alexanderenrique/attiny-e-ink/PCB/attiny-e-ink/attiny-e-ink.csv

Reference | Qty | Value
C1,C2 | 2 | 0.1uF
C3,C4 | 2 | 1uF
C5,C6,C7 | 3 | 4.7uF
D1 | 1 | LED
J1 | 1 | e-ink-display
J2 | 1 | Micro_SD_Card_Det_Hirose_DM3AT
J3 | 1 | Battery
J4 | 1 | USB4085-GF-A
Q1,Q2,Q3 | 3 | DMG2301L
R1,R2,R5 | 3 | 1M
R3,R4 | 2 | 100k
R6 | 1 | 420
R7 | 1 | 10k
R8,R9 | 2 | 5.1k
S1 | 1 | TL1105MF160Q
TP1 | 1 | GND
TP2 | 1 | UPDI
TP3 | 1 | 3.3V
U1 | 1 | ATtiny3226-S
U2 | 1 | TPS7A0233PDBVR
U3 | 1 | MCP73832
