alexanderenrique/attiny-e-ink/fact-aggregator/categorized/history.txt

#History Facts
Telly Savalas and Louis Armstrong died on their birthdays.
Ramses brand condom is named after the great pharaoh Ramses II who fathered over 160 children.
The youngest pope ever was 11 years old.
Australian soldiers used the song "We're Off to See the Wizard" as a marching song in WWII.
When the Titanic sank, 2228 people were on it. Only 706 survived.
A B-25 bomber crashed into the 79th floor of the Empire State Building on July 28, 1945.
King Louis XIX ruled France for 15 minutes.
Jefferson invented the dumbwaiter, the monetary system, and the folding attic ladder.
Baby Ruth candy bar was named after Grover Cleveland’s daughter, Ruth, not the baseball player.
Daniel Boone hated coonskin caps.
In the great fire of London in 1666 half of London was burnt down but only 6 people were injured.
Ancient Egyptian priests would pluck every hair from their bodies.
The electric chair was invented by a dentist.
Adolf Hitler was a vegetarian, and had only ONE testicle.
The first streetlights in America were installed in Philadelphia around 1757.
Johnny Appleseed planted apples so that people could use apple cider to make alcohol.
Samuel Clemens (Mark Twain) was born on and died on days when Halley’s Comet can be seen.
Alabama was the first state to recognize Christmas as an official holiday.
Leonardo da Vinci could write with one hand while drawing with the other
The NY phone book had 22 Hitlers before WWII. The NY phone book had 0 Hitlers after WWII.
The skeleton of Jeremy Bentham is present at all important meetings of the University of London
The Black Death reduced the population of Europe by one third in the period from 1347 to 1351.
Stephen Hawking was born exactly 300 years after Galileo died.
While in Alcatraz, Al Capone was inmate #85.
The very first bomb dropped by the Allies on Berlin during World War II Killed the only elephant in the Berlin Zoo.
John Wilkes Booth’s brother once saved the life of Abraham Lincoln’s son.
US gold coins used to say “In Gold We Trust”.
The first contraceptive was crocodile dung used by the ancient Egyptians.
Sir Isaac Newton was only 23 years old when he discovered the law of universal gravitation.
Winston Churchill was born in a ladies` room during a dance.
Winston Churchill was born in a ladies room during a dance.
Lee Harvey Oswald's cadaver tag sold at an auction for $6,600 in 1992.
Arizona was the last of the 48 adjoining continental states to enter the Union.
The first McDonald's restaurant in Canada was in Richmond, British Columbia.
The word Pennsylvania is misspelled on the Liberty Bell.
The first bomb the Allies dropped on Berlin in WWII killed the only elephant in the Berlin Zoo.
In 1778, fashionable women of Paris never went out in blustery weather without a lightning rod attached to their hats.
Ancient Egyptians shaved off their eyebrows to mourn the deaths of their cats.
Hannibal had only one eye after getting a disease while attacking Rome.
In the last 3,500 years, there have been approximately 230 years of peace throughout the civilized world.
In 1386, a pig in France was executed by public hanging for the murder of a child
Paper was invented early in the second century by Chinese eunuch.
Al Capone`s business card said he was a used furniture dealer.
Mike Nesmith`s (the guitarist of The Monkeys) mom invented White Out.
In the Philippine jungle, the yo-yo was first used as a weapon.
An American urologist bought Napoleon’s penis for $40,000.
Benjamin Franklin was the fifth in a series of the youngest son of the youngest son.
The S in Harry S. Truman did not stand for anything.
Thomas Edison, acclaimed inventor of the light bulb, was afraid of the dark.
Leonardo Da Vinci invented the scissors, the helicopter, and many other present day items.
The Declaration of Independence was written on hemp (marijuana) paper.
Every US president has worn glasses (just not always in public).
Napoleon`s penis was sold to an American Urologist for $40,000.
All US Presidents have worn glasses; some just didn`t like being seen wearing them in public.
Albert Einstein and Charles Darwin both married their first cousins
Einstein couldn`t speak fluently until after his ninth birthday. His parents thought he was mentally retarded.
Frank Lloyd Wright's son invented Lincoln Logs.
The U.S. bought Alaska for 2 cents an acre from Russia.
Dr. Kellogg introduced Kellogg`s Corn Flakes in hopes that it would reduce masturbation.
The shortest British monarch was Charles I, who was 4 feet 9 inches.
Anne Boleyn, Queen Elizabeth I's mother, had six fingers on one hand.
Arabic numerals are not really Arabic; they were created in India.
The shortest war in history was between Zanzibar and England in 1896. Zanzibar surrendered after 38 minutes.
The world’s oldest piece of chewing gum is 9000 years old!
Yo-yos were used as weapons by warriors in the Philippines in the 16th century.
Michigan was the first state to have roadside picnic tables.
John Adams, Thomas Jefferson, and James Monroe died on July 4th.
Most Egyptians died by the time they were 30 about 300 years ago,
Wyoming was the first state to give women the right to vote in 1869.
In medieval France, unfaithful wives were made to chase a chicken through town naked.
Julius Caesar’s autograph is worth about $2,000,000.
The Ramses brand condom is named after the great pharoh Ramses II who fathered over 160 children.
Eating the heart of a male Partridge was the cure for impotence in ancient Babylon.
Pamela Anderson Lee is Canada`s Centennial Baby, being the first baby born on the centennial anniversary of Canada`s independence.
Al Capone’s business card said he was a used furniture dealer.
Jimmy Carter was the first U.S. President to be born in a hospital.
In ancient Rome, when a man testified in court he would swear on his testicles.
Adolf Hitler's mother seriously considered having an abortion but was talked out of it by her doctor.
President John F Kennedy could read 4 newspapers in 20 minutes.
Leonardo Da Vinci invented the scissors.
The earliest known use of cryptography dates to 1900 BC
Frequency analysis, the technique for breaking substitution ciphers, was invented by Arab mathematician Al-Kindi around 800 AD
The Great Cipher used by King Louis XIV remained unbroken for over 200 years (1690-1890)
Polish mathematician Marian Rejewski broke the German Enigma cipher in 1932 using only mathematics and limited documentation
Breaking Enigma shortened World War II by an estimated two years
Public-key cryptography was secretly developed at GCHQ by James Ellis, Clifford Cocks, and Malcolm Williamson in 1973-74
The Zimmermann Telegram's decryption triggered the United States' entry into World War I
Frank Rosenblatt and Marvin Minsky were schoolmates at Bronx High School of Science
Kurt Gödel wrote to John von Neumann in 1956 asking whether theorem-proving could be solved in quadratic time
John Nash wrote to the NSA in 1955 speculating that cracking a sufficiently complex code would require exponential time
The Turing machine was invented in 1936 by Alan Turing
The term 'Turing machine' was coined by Alonzo Church, Turing's doctoral advisor, in a paper review
The FBI seized about 30,000 BTC from Silk Road in October 2013 after arresting founder Ross Ulbricht
Geoffrey Hinton, Yann LeCun, and Yoshua Bengio won the 2018 Turing Award for their work on deep learning
Alan Turing cracked the Enigma code at Bletchley Park
Turing was prosecuted for homosexuality in 1952 and chemically castrated
The South Sea Bubble of 1720 saw shares in the South Sea Company rise 800% in months before collapsing
The 1907 Bankers' Panic was halted by J.P. Morgan personally convincing bankers to contribute to a pool of funds
The Mississippi Bubble of 1720 in France saw John Law's company shares rise 20-fold before collapsing
The German hyperinflation of 1923 was deliberately created to make reparations payments worthless
The Panic of 1893 was triggered by over-expansion of railroads and bank failures
The British Railway Mania of 1847 saw one-third of authorized railways never built after the bubble burst
The Knickerbocker Trust collapse in 1907 triggered a run on other trusts
The Penn Central Railroad bankruptcy in 1970 was the largest in US history at the time
The Lehman Brothers collapse on September 15, 2008 triggered the worst phase of the financial crisis
The Northern Rock bank run in 2007 was the first run on a British bank in 150 years
Experimental economics earned Vernon Smith the 2002 Nobel Prize
The oldest evidence of winemaking dates to around 6000 BC in Georgia, in the Caucasus region.
Nutmeg, native to the Banda Islands in Indonesia, was introduced to Europe by the 6th century BCE.
Cave paintings in Spain show humans gathering honey at least 8,000 years ago.
Mayans practiced large-scale meliponiculture (stingless bee keeping) since pre-Columbian times.
Cacao was considered a gift from the gods by both the Maya and the Aztecs, and cocoa beans were used as currency.
It took until 1585 for the first official shipment of cocoa beans to reach Europe from the Americas.
All 13 vitamins were discovered between 1910 and 1948, revolutionizing our understanding of nutrition.
The ancient Egyptians knew that feeding liver (rich in vitamin A) could cure night blindness, though they didn't know why.
Wild olives were collected by Neolithic people as early as the 8th millennium BCE in Asia Minor.
The first probiotic discovered was Lactobacillus bulgaricus in Bulgarian yogurt, identified by Stamen Grigorov in 1905.
The term 'antioxidant' originally referred to chemicals that prevented oxygen consumption in industrial processes like rubber vulcanization.
Cheese making dates back at least 7,500 years—ancient pottery with milk fat residue has been found from that era.
Cheese was likely discovered accidentally when milk stored in animal stomach pouches curdled from residual rennet enzymes.
Beer brewing dates back at least 5,000 years to ancient Sumer, where it was considered a divine gift.
Black pepper was once so valuable it was called 'black gold' and used as currency in medieval trade.
Sushi originally meant fermented fish preserved in rice for months—modern 'fast sushi' developed in 19th-century Tokyo.
Tofu was invented in China around 2,000 years ago, possibly by accident when nigari (a coagulant) contaminated soy milk.
Ketchup was originally made from fermented fish or mushrooms in 18th-century Britain—tomato ketchup is an American invention from the 1800s.
Mustard is one of the world's oldest condiments—it has been used for over 5,000 years, originally in ancient China and India.
Francis Galton calculated in 1892 that the chance of two different individuals having the same fingerprints was about 1 in 64 billion.
The Vinland Map was identified as a 20th-century forgery through chemical trace evidence analysis of its ink composition.
Archibald Reiss founded the world's first school of forensic science at the University of Lausanne in 1909.
The FBI launched its Computer Analysis and Response Team in 1984, marking the beginning of specialized digital crime investigation units.
SMS data from mobile forensics helped exonerate Patrick Lumumba in the Amanda Knox case (murder of Meredith Kercher).
The Thomas Onofri kidnapping was solved in 2006 through mobile phone location data tracked via cell site logs.
The Jack the Ripper case from 1888 remains unsolved over 135 years later, despite numerous theories and modern forensic analysis attempts.
The Wall Street bombing of 1920 has never been positively solved, though the Galleanist anarchist group is widely believed responsible.
The Dos Erres massacre conviction resulted in sentences of 6,060 years for each perpetrator—among the longest prison sentences ever issued.
The first known manual alphabet for deaf people was developed by a Spanish monk, Pedro Ponce de León, in the 16th century.
The oldest known dictionary is from ancient Mesopotamia (c. 2300 BCE) — a Sumerian-Akkadian bilingual word list.
The Rosetta Stone (196 BCE) contained the same text in three scripts: hieroglyphic, demotic Egyptian, and Greek
Quipu, the Incan system of knotted cords, could encode administrative data but remains only partially deciphered
Cuban insurgents during Spanish occupation developed a secret whistled language for communication
The first practical piezoelectric application was sonar during World War I, developed by Paul Langevin in 1917 for detecting submarines.
The Lyres of Ur, excavated from Sumerian graves dated 2600-2500 BC, represent one of the first ensembles of instruments ever discovered.
In 1902 alone, there were 70,000-75,000 player pianos manufactured and 1-1.5 million piano rolls produced in the United States.
The Dyatlov Pass incident, where nine Soviet hikers died mysteriously in 1959, has infrasound hypothesized as one possible cause of death.
In ancient China, written records describe music as essential medicine—'at the end of a song, people were safe when they were discharged'.
The first bagpipes appeared in the 9th century and spread throughout Europe, serving functions from folk instruments to military use.
Underwater acoustics was first used militarily to detect submarines in World War I.
Lord Rayleigh's The Theory of Sound (1877) combined all previous acoustic knowledge and remains influential in the field today.
Thomas Edison may have accidentally created graphene in 1879 while testing carbon-based bamboo filaments for light bulbs
The tin can was patented in 1810 by Peter Durand, but the can opener wasn't patented until 1858
Marie Curie remains the only person to earn Nobel Prizes in two different sciences (Physics in 1903 and Chemistry in 1911).
In 1912, Barnum & Bailey trained elephants to play baseball - they used the image on posters to sell circus tickets.
Dream interpretation was practiced by Babylonians as early as the third millennium BCE.
Calvin S. Hall collected over 50,000 dream reports between the 1940s and 1985 for scientific analysis.
In ancient Sumer, King Gudea rebuilt a temple based on instructions received in a dream around 2140 BCE.
Scientists who discovered REM sleep in 1953 were Eugene Aserinsky and Nathaniel Kleitman.
Thomas Edison slept only 4 hours a night and promoted the idea that sleep was a waste of time.
Leonardo da Vinci allegedly practiced polyphasic sleep with multiple 20-minute naps throughout the day.
Copper has been used by humans for over 10,000 years and remains essential in electrical wiring due to its conductivity.
Lead has been used for 6,000 years and was once added to gasoline, paint, and even food as a sweetener.
Tin has been alloyed with copper to make bronze since 3000 BCE, revolutionizing human civilization.
Aluminum was once more valuable than gold - Napoleon III served honored guests with aluminum cutlery while others used gold.
Hammurabi was discovered by Austen Henry Layard.
An official investigation found the Fukushima nuclear accident was foreseeable and preventable.
Approximately 85 per cent of Welsh children were not in school in 1821.
The Palace Theater light bulb has been running since 1908.
Trembleuse cups and saucers enabled people with unsteady hands to drink hot beverages.
French soldiers interred in Bayonet Trench were popularly believed to have been buried alive with their rifles in their hands.
Bob Hobman recreated a possible sea journey by Palaeolithic humans after 130,000-year-old tools were found on the island of Crete.
An enigmatic ancient site deep in Madagascar (Teniky) may have been built by Zoroastrians.
Kent Brushes have supplied their products to every British monarch since George IV.
The Haitian Revolution began when Cécile Fatiman sacrificed a black pig, a ritual later repeated by Haitians resisting foreign occupation.
An ancient Canadian archaeological site (GhGk-63) was discovered during the construction of a dump.
A Cretan man found a 1st-century statue of Aphrodite (Aphrodite Rhithymnia) while trying to drill a well, and then reburied it.
The Italian Campaign of 1796–1797 demonstrated that Napoleon was a 'great strategist'.
Papyrus Bingen 45 may contain a word handwritten by Cleopatra.
Cecil Kent Drinker published his report on the Radium Girls only after a forged version was submitted in his name.
The Indian emperor Jahangir commissioned a painting depicting his superiority over his rival, the Shah of Iran.
German colonists were unable to win a war that they started with an unprovoked massacre (Hornkranz massacre).
The concept of genocide was introduced in the 1944 book Axis Rule in Occupied Europe.
A shipwreck in the eastern Mediterranean, dating from the Late Bronze Age, is the earliest deep-sea shipwreck to be discovered.
John S. McCain Sr. and John S. McCain Jr. were the first father-and-son pair to achieve the U.S. rank of four-star admiral.
Lionel Haward applied an early example of offender profiling to help identify high-ranking Nazis disguised as ordinary troops.
Niall Ó Glacáin, an Irish physician, worked as a travelling plague doctor in southern France in the 1620s.
The surviving copies of the Kitab-ı Bahriye contain a total of more than 5,700 maps.
The September 11 Digital Archive argues that even its misinformation is useful to the historical record.
The Zoninus collar is the only known Roman slave collar that offers a reward for returning its wearer.
A nuclear reactor was nearly built at the New York Hall of Science, but the money instead went to Yankee Stadium.
38 per cent of Welsh university students in 1900 were women.
The British Army's Submarine Mining Service defended ports and harbours with naval mines and torpedoes.
30 royal portraits of Korean kings were completely destroyed in a 1954 fire in Busan, South Korea.
Darwin's first sketch of an evolutionary tree" src="//upload.
The first prize in physics was awarded in 1901 to Wilhelm Conrad Röntgen, of Germany, who received 150,782 SEK.
John Bardeen is the only laureate to win the prize twice—in 1956 and 1972.
William Lawrence Bragg was the youngest Nobel laureate in physics; he won the prize in 1915 at the age of 25.
A 2020 study reported that half of the Nobel Prizes for science awarded between 1995 and 2017 are clustered in few disciplines.
The first Nobel Prize in Chemistry was awarded in 1901 to Jacobus Henricus van 't Hoff, of the Netherlands.
The first Nobel Prize in Physiology or Medicine was awarded in 1901 to Emil Adolf von Behring, of Germany.
In 1939 Gerhard Domagk, a German, was not allowed by his government to accept the prize.
First African-American woman to receive a United States patent.
Levin was not aware of Cook's achievement because of communication difficulties between East and West during the Cold War.
The Moon Halley wasn't the first to figure out the famous comet.
An 11th-century monk did it first, new research suggests.
Cleopatra lived closer in time to the Moon landing than to the building of the Great Pyramid.
Oxford University is older than the Aztec Empire.
The inventor of the frisbee was turned into a frisbee after death — his ashes were molded into memorial discs.
The shortest war in history lasted 38 minutes — between Britain and Zanzibar in 1896.
The inventor of the Pringles can is buried in one, as per his request.
A 'moment' was a medieval unit of time equal to 90 seconds.
The inventor of the steamboat was an artist first.
The inventor of the telegraph was also a painter.
The inventor of silk discovered it accidentally.
Nikola Tesla had a photographic memory and could visualize entire machines in his head, building them mentally before ever touching a tool.
Darwin waited 20 years to publish On the Origin of Species because he knew how controversial it would be.
Isaac Newton invented calculus during quarantine when Cambridge closed due to the plague.
Einstein's brain was stolen during his autopsy and kept in jars for decades before being studied.
The scientist who proposed hand-washing to prevent infection was ridiculed by the medical community and died in an insane asylum.
Galileo's middle finger is on display in a museum in Florence, Italy.
Leonardo da Vinci wrote backwards in mirror script, possibly to keep his ideas secret or because he was left-handed.
Werner Heisenberg, creator of the uncertainty principle, got a C in lab work because his experimental skills were poor.
Aristotle believed women had fewer teeth than men — he never bothered to count, despite having two wives.
Benjamin Franklin nearly electrocuted himself and was knocked unconscious while experimenting with electricity.
Carl Sagan applied to work at NASA but was rejected
Einstein was offered the presidency of Israel but declined, saying he lacked the natural aptitude for dealing with people.
Thomas Edison electrocuted an elephant named Topsy to prove the dangers of his rival Tesla's AC current.
Archimedes was killed by a Roman soldier while doing geometry in the sand
Darwin and Lincoln were born on the exact same day — February 12, 1809.
Louis Pasteur was so afraid of germs that he refused to shake hands with people.
Copernicus's book proposing heliocentrism was only banned by the Catholic Church 73 years after publication.
Pythagoras's followers kept his teachings secret and were sworn to silence
Robert Hooke and Isaac Newton were bitter rivals — Newton allegedly had Hooke's portrait destroyed after Hooke died.
Marie Curie remains the only person to win Nobel Prizes in two different sciences: Physics and Chemistry.
The ancient Egyptians used moldy bread to treat infected wounds — accidentally discovering antibiotic properties.
Lavoisier, the father of modern chemistry, was executed during the French Revolution
Feynman cracked safes at Los Alamos for fun during the Manhattan Project, causing security concerns.
Wernher von Braun designed rockets for Nazi Germany before becoming the architect of NASA's Apollo program.
Ancient Babylonians were doing trigonometry 1,000 years before the Greeks — clay tablets prove it.
Lobsters were once considered food for the poor.
The inventor of the telephone, Alexander Graham Bell, never called his wife or mother.
The inventor of Pringles is buried in a Pringles can.
The shortest war in history lasted 38 to 45 minutes.
The inventor of the frisbee was cremated and made into frisbees.
Cleopatra lived closer to the Moon landing than to the building of the Great Pyramid.
Nintendo was founded in 1889 as a playing card company, over 100 years before they made video games.
The first alarm clock could only ring at 4 AM because it was made for factory workers.
The match was invented 27 years after the lighter — lighters came first in 1823, matches in 1850.
The ancient Egyptians used mashed brains as a contraceptive.
Romans used crushed mouse brains as toothpaste.
Cleopatra spoke nine languages and was the first Ptolemaic ruler to learn Egyptian.
The Library of Alexandria may have contained 400,000 to 700,000 scrolls.
Vikings used the bones of slain animals as skates.
Mummies have been found with cocaine and tobacco traces, suggesting pre-Columbian trade routes.
Doctors used to taste urine to diagnose diabetes — sweet urine indicated the disease.
Walt Disney was originally offered a deal that was worth $2 billion to create a theme park in Missouri.
Play-Doh was originally a wallpaper cleaner.
Nintendo was founded in 1889 as a playing card company.
Zero was invented independently in India and by the Maya, but the Romans never had a symbol for it.
Roman numerals have no symbol for zero, which made complex math nearly impossible.
A baker's dozen (13) exists because medieval bakers could be punished for short-changing customers.
The number 666 is called the 'number of the beast,' but some ancient manuscripts say it's actually 616.
The ancient Egyptians only used unit fractions (1/n) and had to express 2/5 as 1/3 + 1/15.
The ancient Babylonians used base-60, which is why we have 60 seconds in a minute and 360 degrees in a circle.
The inventor of vaseline ate a spoonful every day.
The Titanic was carrying 12 dogs, 3 of which survived.
Ancient Romans used urine to whiten their teeth.
The inventor of the Frisbee was cremated and turned into frisbees.
Cleopatra lived closer to the iPhone than to the pyramids.
The shortest war lasted 38 minutes.
The inventor of the lobotomy won a Nobel Prize.
The inventor of the fire hydrant is unknown — records burned.
The inventor of the Pringles can is buried in one.
Phosphorus was discovered by a German alchemist boiling his own urine to find gold
The inventor of the treadmill created it as a prison punishment.
The inventor of the AK-47 regretted his creation.
The inventor of dynamite created the Nobel Prize.
The inventor of the telephone never called his family.
The inventor of the guillotine opposed the death penalty.
The inventor of the escalator was afraid to ride it.
The inventor of the shopping cart hired actors to use it.
The inventor of barbed wire changed the American West.
The inventor of the sewing machine had his shop burned down.
The inventor of the cotton gin made slavery more profitable.
The inventor of the bra was a socialite.
The inventor of the printing press was a goldsmith.
The inventor of the parachute never tested it himself.
The inventor of the revolver was 18 years old.
The inventor of the phonograph was partially deaf.
German chocolate cake was named after Sam German, not Germany.
Cotton candy was co-invented by a dentist in 1897.
Mountain Dew was originally created as a whiskey chaser.
The shortest war in history lasted 38-45 minutes between Britain and Zanzibar on August 27, 1896.
Cleopatra lived closer in time to the Moon landing than to the construction of the Great Pyramid.
The inventor of the Pringles can is buried in one - Fredric Baur's ashes were placed in a Pringles can.
The inventor of the fire hydrant is unknown because the patent was destroyed in a fire.
The first alarm clock could only ring at 4 AM - invented by Levi Hutchins in 1787.
The inventor of Vaseline ate a spoonful of it every day believing it had health benefits.
The shortest war in history was between Britain and Zanzibar in 1896 - Zanzibar surrendered after just 38 minutes.
The inventor of the telephone, Alexander Graham Bell, never called his wife or mother because they were both deaf.
The shortest war ever fought lasted only 38 minutes.
The first photograph ever taken was in 1826 and required an 8-hour exposure.
The oldest known cave painting is over 64,000 years old, found in Spain.
One estimate is that 85 per cent of children in Wales aged five to fifteen were not in day school in 1821.
In a murder case dated 1235, a Chinese magistrate had villagers assemble and set down their sickles
From 1892 to 1924, Ellis Island was America's largest and most active immigration station, where over 12 million immigrants were processed.
Ferdinand Magellan named the Pacific Ocean after entering it in November 1520, because of the calmness of the water at the time.
On his midnight ride, Paul Revere was intercepted by a British patrol after leaving Lexington and never reached Concord.
The Pony Express was in operation for only 18 months, between April 1860 and October 1861.
Only one helmet from the Viking Age has been preserved, and it does not have horns.
The engrossed Declaration of Independence was signed on August 2, 1776, not on July 4.
The earliest Sumerian clay tablets from around 3000 BC list hundreds of medicinal plants including opium and myrrh.
Morphine was the first alkaloid isolated from a plant (opium poppy) in 1806, launching modern pharmaceutical chemistry.
Ötzi the Iceman, frozen in the Alps for 5,000+ years, carried a mushroom possibly used as medicine against whipworm parasites.
Opium poppy was listed on Sumerian clay tablets around 3000 BC—among humanity's oldest documented medicinal plants.
George Bernard Shaw was “intensely disturbed” after seeing a demonstration in which a cabbage appeared to convulse while boiling.
Charles Elton's 1958 book 'The Ecology of Invasion by Animals and Plants' created the foundation for modern invasion biology.
In New Zealand, dogs and rats brought by Polynesian settlers around 1300 CE were the first invasives, devastating endemic wildlife.
Acclimation societies in colonial times deliberately introduced European plants and animals, feeling this 'improved' nature.
Aconitum (monkshood/wolfsbane) was historically used as arrow poison and to kill wolves—all parts are extremely toxic.
The death camas (Zigadenus) is so toxic that it killed many pioneers who mistook it for edible wild onions.
White snakeroot caused 'milk sickness' that killed Abraham Lincoln's mother—cattle ate the plant and toxin passed through milk.
Hemlock (Conium maculatum) was used to execute Socrates—it causes ascending paralysis, eventually stopping the heart.
Original Coca-Cola contained coca leaf extract until 1903; today a 'decocainized' extract is still used for flavor.
Coffee was supposedly discovered when Ethiopian goatherds noticed their goats acting energetic after eating coffee berries.
Tea was supposedly discovered in 2737 BCE when leaves blew into Chinese Emperor Shennong's boiling water.
The first gale warning service began in February 1861 when Robert FitzRoy used telegraph communications to warn ships of approaching storms.
Chinese weather prediction methods extend at least as far back as 300 BC, around the same time as ancient Indian weather-prediction methods.
Tree ring analysis for climate study wasn't solidly established as a science until the 1960s, despite earlier pioneering work.
Louis Agassiz omitted mention of Karl Friedrich Schimper, who coined 'ice age' and helped develop the theory, due to personal quarrels.
Fleas transmitted the Black Death, killing an estimated 75–200 million people in the 14th century, about a third of Europe's population.
Traces of tetracycline have been found in human bones from ancient Sudanese Nubia dating to 350-550 CE
The first antibiotic used in hospitals, Pyocyanase (1899), was made from Pseudomonas aeruginosa bacteria — decades before penicillin.
The golden era of antibiotic discovery was the 1950s-1970s — no new antibiotic classes have been discovered since then.
Red soils in Jordan have been used for thousands of years to treat skin infections
Paul Ehrlich tested 606 different compounds before finding Salvarsan
Walter Fiers in 1976 was the first to sequence a complete viral genome — bacteriophage MS2 — launching the era of genomics.
Stanley Prusiner won the 1997 Nobel Prize for discovering prions — initially ridiculed for proposing a protein-only infectious agent.
In 1896, Ernest Hanbury Hankin discovered something in the Ganges River that killed cholera bacteria.
Phages were used to treat Red Army soldiers in World War II
The Luria-Delbrück experiment (1943) used phages to prove that bacterial mutations occur randomly.
Artemisinin — the anti-malarial drug from traditional Chinese medicine — was used for thousands of years before modern isolation.
Fleming warned about penicillin resistance in his 1945 Nobel lecture — predicting the crisis before it began.
R-plasmids (resistance plasmids) were discovered in Japan in the 1950s during Shigella dysentery outbreaks.
The first whole-genome sequence of a free-living organism was that of Haemophilus influenzae in 1995.
In ancient China, dinosaur bones were often mistaken for dragon bones and ground up for use in traditional medicine and aphrodisiacs.
The term 'living fossil' was coined by Charles Darwin in 1859 when discussing the platypus and South American lungfish.
The first depiction of a feathered dinosaur was by Thomas Huxley in 1876, showing a feathered Compsognathus.
Archaeoraptor, announced in 1999, was a famous forgery made by combining parts of a bird and a dinosaur
Dinosaur eggs were first scientifically described in 1923 from the Gobi Desert, initially misattributed to the herbivore Protoceratops.
The 'dinosaur renaissance' of the 1960s-70s overturned the view of dinosaurs as sluggish cold-blooded animals.
John Ostrom's description of Deinonychus in 1969 was a turning point that showed dinosaurs as active, potentially warm-blooded animals.
The land bridge between Asia and North America (Beringia) allowed humans to migrate to the Americas.
The term 'ice age' was coined in 1837 by the German botanist Karl Friedrich Schimper.
Louis Agassiz popularized the ice age theory, though he built upon earlier work by others.
Before ice age theory was accepted, scientists attributed erratics and glacial features to biblical floods.
Mary Anning, one of the most important fossil hunters in history, discovered the first complete ichthyosaur skeleton at age 12 in 1811.
Mary Anning's discoveries fundamentally changed scientific understanding of prehistoric life, though as a woman she was often denied credit.
The Crystal Palace dinosaur sculptures, created in 1854, were the world's first life-sized dinosaur models.
Gideon Mantell, who described Iguanodon, originally placed its thumb spike on its nose like a rhinoceros horn.
Hadrosaurus, discovered in New Jersey in 1858, was the first dinosaur skeleton mounted for public display in the world.
The first nearly complete dinosaur skeleton found in America was unearthed from a marl pit in Haddonfield, New Jersey.
Human knowledge of parasites dates back to ancient Egypt, Greece, and Rome.
The malaria parasite was discovered by Charles Louis Alphonse Laveran in 1880 in Algeria
Ronald Ross discovered that mosquitoes transmit malaria in 1897, but initially proved this in bird malaria
Malaria was well known to ancient civilizations — Hippocrates described tertian and quartan fevers around 400 BCE.
The 1940s treatment for tapeworms involved inserting oleoresin of aspidium directly into the duodenum via a tube — primitive but effective.
In 1922, scientist Shimesu Koino deliberately swallowed 2,000 Ascaris eggs to prove the parasite's life cycle
Antonie van Leeuwenhoek first observed the parasite Giardia lamblia with his microscope in 1681
Geologist Gilbert Wilson was the fifth Wilson at school, so he was known as 'Quintus'.
Maria Muntañola Cvetković became one of Yugoslavia's first experts on microfungi after fleeing to Argentina as a Spanish Civil War refugee.
Canadian microbiologist Patricia Taylor helped American diplomats hide in her house in Tehran during the Iran hostage crisis.
A recurrent famine (Kere) has haunted Madagascar's southern regions since the 1930s.
During the colonial period, the Dutch East Indies was the third-largest exporter of tea after the British Raj and Ceylon.
Harry S. Truman declined a mayor's suggestion to fire a nuclear bomb at a hurricane.
In 1253 Henry III of England ordered that his white bear be permitted to swim and hunt in the River Thames.
Entomologist Charles De Geer made all the illustrations for his eight-volume work himself.
Storm Ulysses in 1903 was so named because its effects were described in James Joyce's novel Ulysses.
The ocean contains more historic artifacts than all the world's museums combined.
The loudest sound ever recorded was the 1883 Krakatoa eruption.
There are more historical artifacts in the ocean than in all museums combined.
James Cameron dove solo to Challenger Deep.
Mount Tambora's eruption caused the Year Without a Summer.
Krakatoa's explosion was heard 3,000 miles away.
Mount St. Helens erupted in 1980.
Pompeii was buried by Mount Vesuvius in 79 AD.
The Human Genome Project took 13 years.
The largest volcanic eruption in recorded history was Mount Tambora in 1815.
The first antibiotic-resistant bacteria were discovered in 1945, just years after penicillin.
The first successful clone of a mammal was Dolly the sheep in 1996.
Yersinia pestis caused the Black Death pandemic.
Beavers were declared to be fish by the Church, so practicing Catholics could eat their tails for Lent
Ancient Egyptians shaved their eyebrows when mourning a departed cat
In the 1900s, fur traders hunted chinchillas with dynamite.
Dingoes can be found in cave paintings.
In 1900, approximately 130,000 horses were working in Manhattan.
Horses were domesticated about 6,000 years ago
Llamas were used to carry building materials during the construction of Machu Picchu.
Christopher Columbus mistook a manatee for a mermaid
Ancient Europeans once used pigs to get rid of sewage
U.S. Navy Squadron VF 33, from NAS Oceana, Va., has the tarsier as its squadron mascot and insignia.
Their origin story stems from a travelling farmworker: John Tinsley brought four fainting goats to Tennessee in the 1880s.
Lampreys are regicidal. In the 12th century, they were popular as a food source.
Norway knighted a penguin.
The CIA once wired a cat to be a roaming spy, but it didn't work: it got hit by a car.
Drug dealer Pablo Escobar lost a bunch of money to rats; they ate it.
Rock paintings of bees date back 15,000 years
Cave bears may have been worshiped by primitive humans.
One of the Corkie’s parent breeds, the Cocker Spaniel, was thought to have come over on the Mayflower.
Ownership of this dog was once restricted to the Hungarian nobility
This breed traveled with the Vikings!
Their fur has been considered a luxury item since the Middle Ages
Ferrets were used during the Revolutionary War to keep down the rat population.
The ancient Egyptians worshipped scarabs.
In certain Pacific island communities, balloonfish were historically fashioned as helmets.
Weddell seals are named for Captain James Weddell, an explorer in the 1820s whose book described and illustrated Weddell seals.
A solar eclipse helped end a six-year war in 585 BCE
The two victims of the Zénith balloon incident are depicted holding hands on their tomb.
