alexanderenrique/attiny-e-ink/PCB/attiny-e-ink/attiny-e-ink.kicad_pcb

## KiCad design PCB/attiny-e-ink/attiny-e-ink.kicad_pcb (2026-10-29)

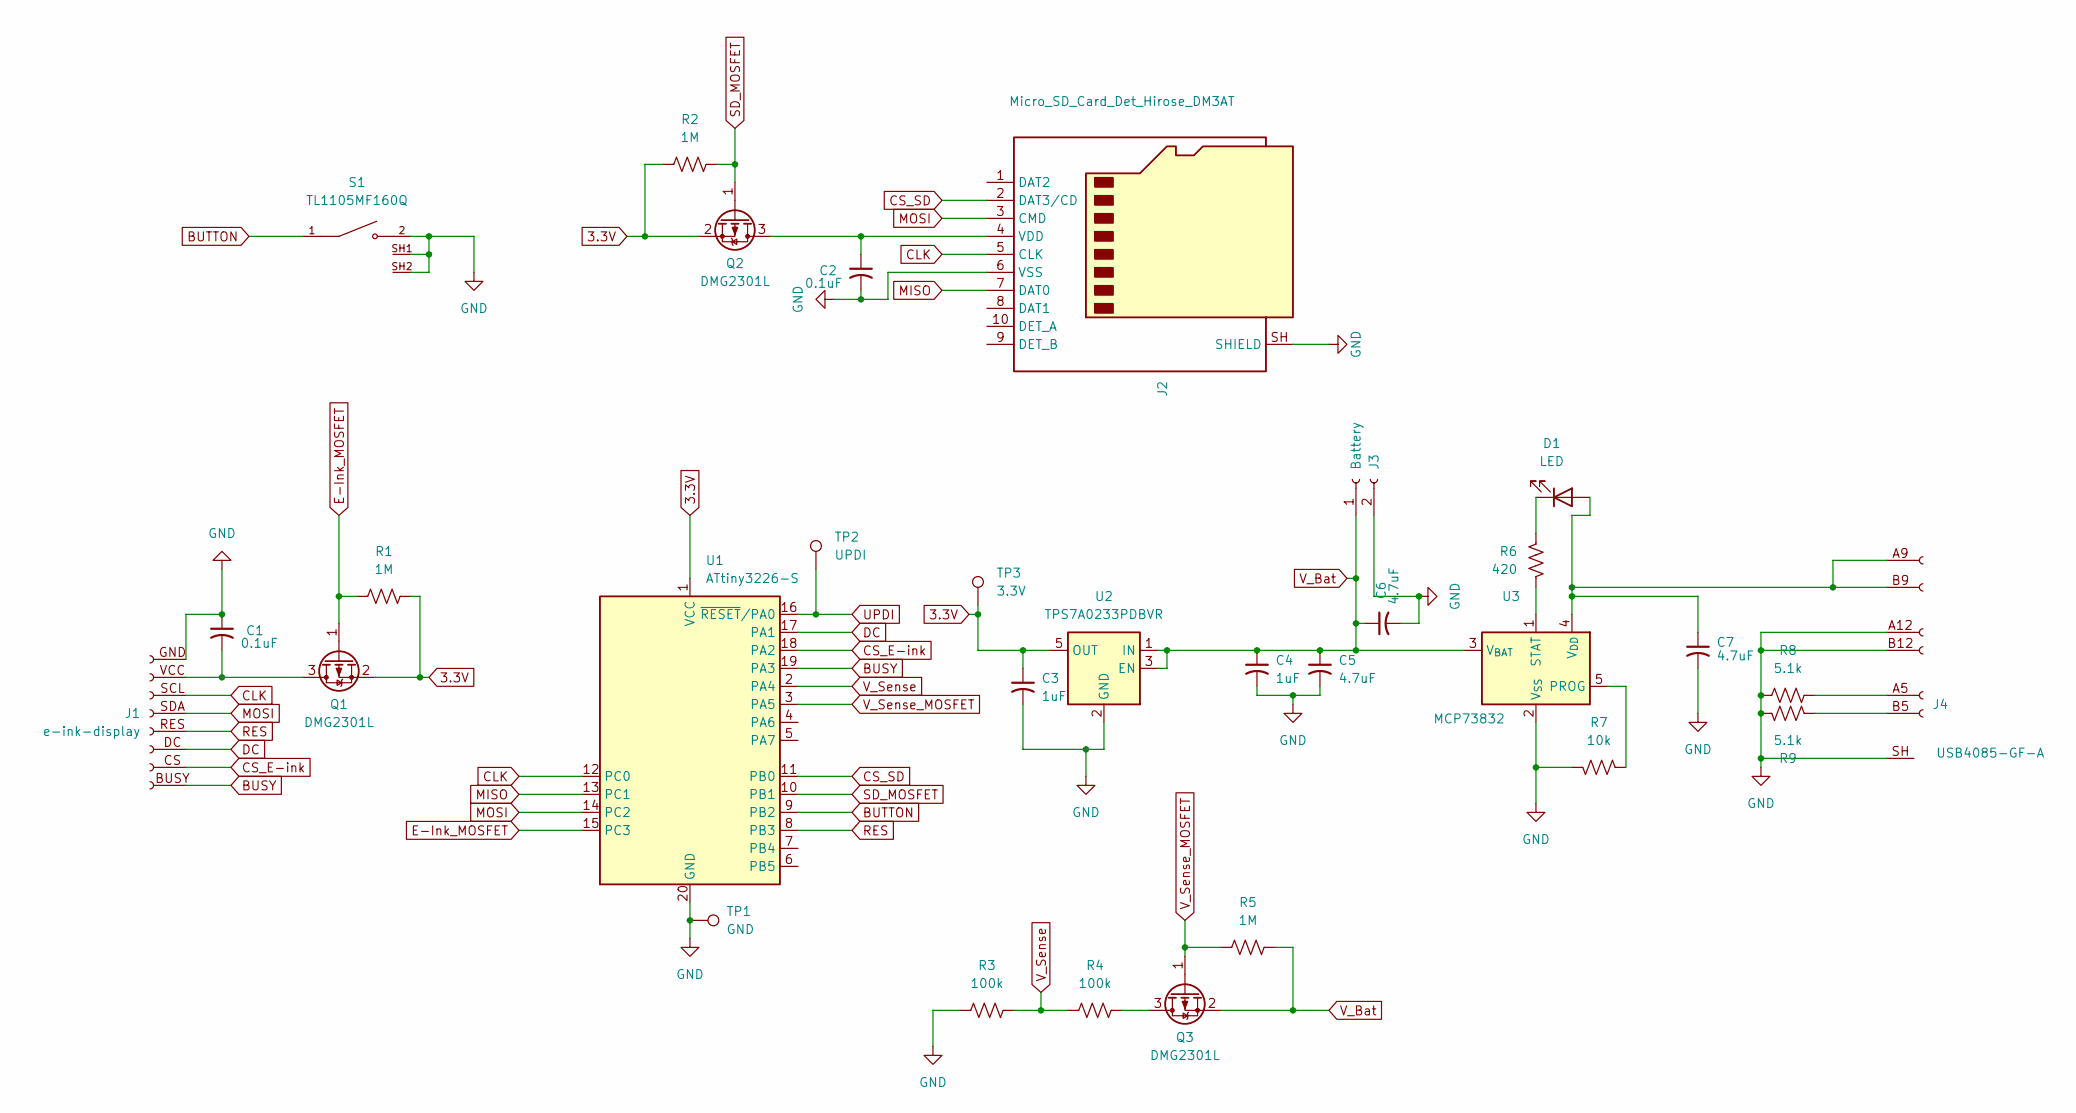
[picture p1: schematic attiny-e-ink.kicad_sch]

Parts:
C1, C2: 0.1uF; C_1206_3216Metric
C3, C4: 1uF; C_1206_3216Metric
C5, C6, C7: 4.7uF; C_1206_3216Metric
D1: LED; LED_1206_3216Metric
J1: e-ink-display; PinHeader_1x08_P2.54mm_Vertical
J2: Micro_SD_Card_Det_Hirose_DM3AT; microSD_HC_Hirose_DM3AT-SF-PEJM5
J3: Battery; CONN02_530480210_MOL
J4: USB4085-GF-A; USB_C_Receptacle_GCT_USB4125-xx-x_6P_TopMnt_Horizontal
Q1, Q2, Q3: DMG2301L; SOT-23
R1, R2, R5: 1M; R_1206_3216Metric
R3, R4: 100k; R_1206_3216Metric
R6: 420; R_1206_3216Metric
R7: 10k; R_1206_3216Metric
R8, R9: 5.1k; R_1206_3216Metric
S1: TL1105MF160Q; SW_TL1105MF160Q; PARTREV E
TP1: GND; TestPoint_Pad_D1.5mm
TP2: UPDI; TestPoint_Pad_D1.5mm
TP3: 3.3V; TestPoint_Pad_D1.5mm
U1: ATtiny3226-S; SOIC-20W_7.5x12.8mm_P1.27mm
U2: TPS7A0233PDBVR; SOT-23-5
U3: MCP73832; SOT-23-5

Connections:
3.3V: C3.1, Q1.2 (S), Q2.2 (S), R1.1, R2.2, TP3.1 (1_1), U1.1 (VCC), U2.5 (OUT)
BUSY: J1.BUSY (Pin_8), U1.19 (PA3)
BUTTON: S1.1, U1.9 (PB2)
CLK: J1.SCL (Pin_3), J2.5 (CLK), U1.12 (PC0)
CS_E-ink: J1.CS (Pin_7), U1.18 (PA2)
CS_SD: J2.2 (DAT3/CD), U1.11 (PB0)
DC: J1.DC (Pin_6), U1.17 (PA1)
E-Ink_MOSFET: Q1.1 (G), R1.2, U1.15 (PC3)
GND: C1.1, C2.2, C3.2, C4.2, C5.2, C6.2, C7.2, J1.GND (Pin_1), J2.6 (VSS), J2.SH (SHIELD), J3.2 (Pin_1), J4.A12 (Pin_8), J4.B12 (Pin_10), J4.SH (Pin_10), R3.2, R7.1, R8.2, R9.2, S1.2, S1.SH1, S1.SH2, TP1.1 (1_1), U1.20 (GND), U2.2 (GND), U3.2 (V_{SS})
MISO: J2.7 (DAT0), U1.13 (PC1)
MOSI: J1.SDA (Pin_4), J2.3 (CMD), U1.14 (PC2)
unnamed: C7.1, D1.2 (A), J4.A9 (Pin_2), J4.B9 (Pin_4), U3.4 (V_{DD})
unnamed: D1.1 (K), R6.2
unnamed: C1.2, J1.VCC (Pin_2), Q1.3 (D)
unnamed: C2.1, J2.4 (VDD), Q2.3 (D)
unnamed: J4.A5 (Pin_8), R8.1
unnamed: J4.B5 (Pin_10), R9.1
unnamed: Q3.3 (D), R4.1
unnamed: R7.2, U3.5 (PROG)
unnamed: R6.1, U3.1 (STAT)
RES: J1.RES (Pin_5), U1.8 (PB3)
SD_MOSFET: Q2.1 (G), R2.1, U1.10 (PB1)
UPDI: TP2.1 (1_1), U1.16 (~RESET/PA0)
V_Bat: C4.1, C5.1, C6.1, J3.1 (Pin_2), Q3.2 (S), R5.1, U2.1 (IN), U2.3 (EN), U3.3 (V_{BAT})
V_Sense: R3.1, R4.2, U1.2 (PA4)
V_Sense_MOSFET: Q3.1 (G), R5.2, U1.3 (PA5)

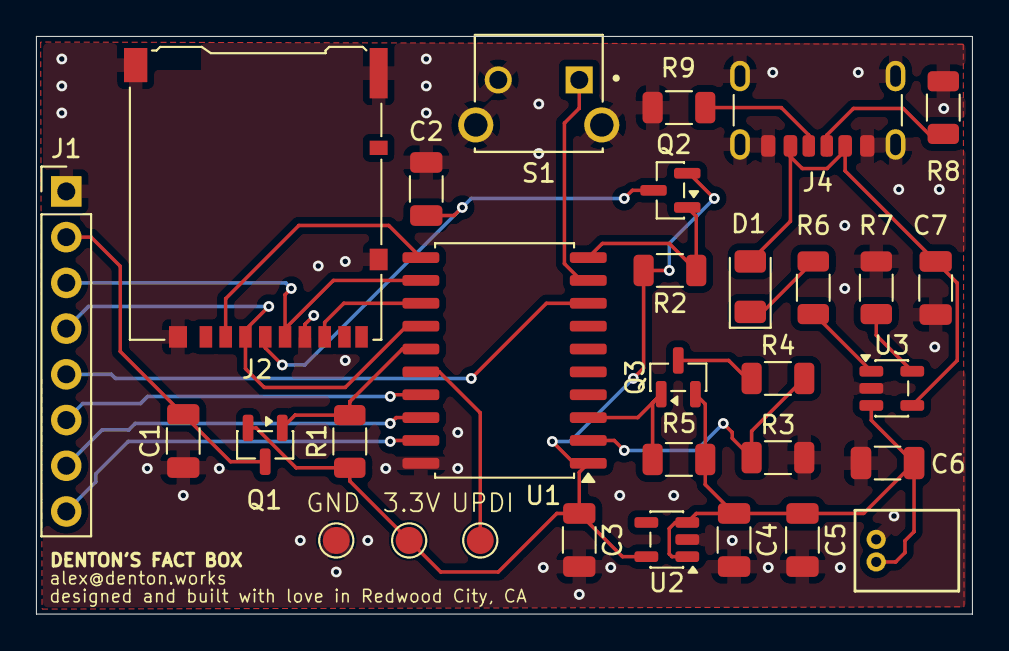
[picture p2: board attiny-e-ink.kicad_pcb from above]

Board: 2 copper layers, 52.0 x 32.1 mm, 31 parts (0 on the bottom side), 26 nets.
