alexanderenrique/attiny-e-ink/(commit log)

2026-10-08 Add the ATtiny3226 e-ink quote display firmware and KiCad board.
    Keep PlatformIO builds and KiCad history, backups, and fab plots out of the repo.
    [attiny-e-ink.kicad_pcb, attiny-e-ink.kicad_sch, config.txt]
2026-10-24 code checkpoint
    [attiny-e-ink.csv, attiny-e-ink.kicad_pcb]
2026-10-25 working, lengthened display power rail, still slow refresh
2026-10-29 check point
    [attiny-e-ink.kicad_pcb, attiny-e-ink.kicad_sch, attribution.csv, config.txt]
